rusty-dev0/Colosseus/Images/colosseusButGlowy.jpg

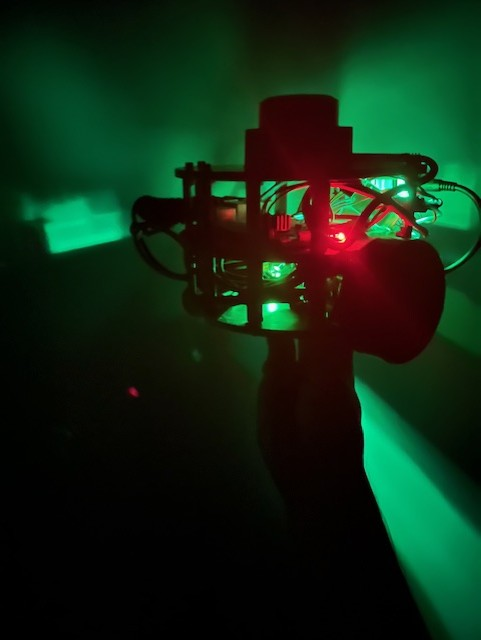
Images/colosseusButGlowy.jpg
