rusty-dev0/Colosseus/Images/colosseusButGlowyFromTheBack.jpg

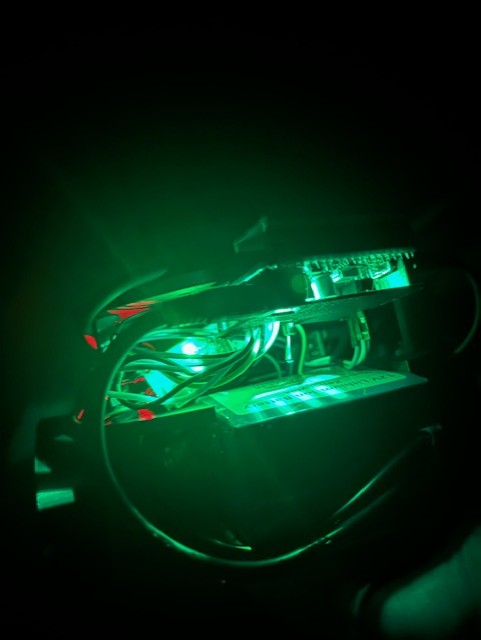
Images/colosseusButGlowyFromTheBack.jpg
