rusty-dev0/Colosseus/Images/colosseusButOnMyCounter.jpg

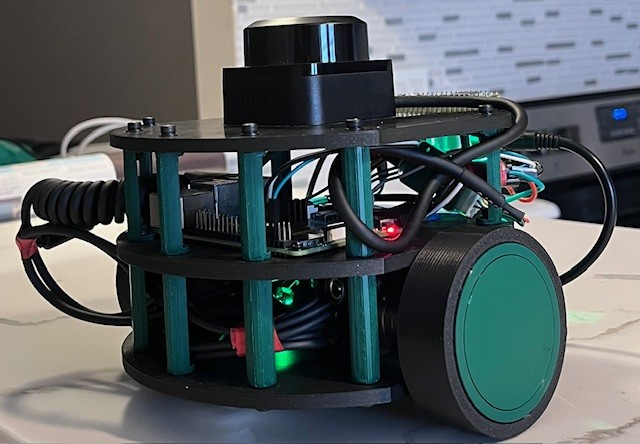
Images/colosseusButOnMyCounter.jpg
