rusty-dev0/Colosseus/chassis/step/MotorStrap.step

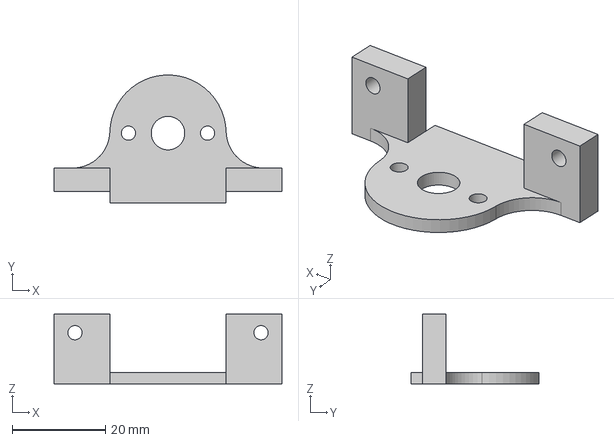
[picture p9: CAD file, 2026-10-31]
chassis/step/MotorStrap.step
49.0 x 27.5 x 15.0 mm
