rusty-dev0/Colosseus/(list of files, cad)

Other CAD files:
chassis/fusion/MotorStrap.f3d
